Julius-eng/Vector-BMS/MCU.kicad_sch

## KiCad design MCU.kicad_sch (2026-03-11)

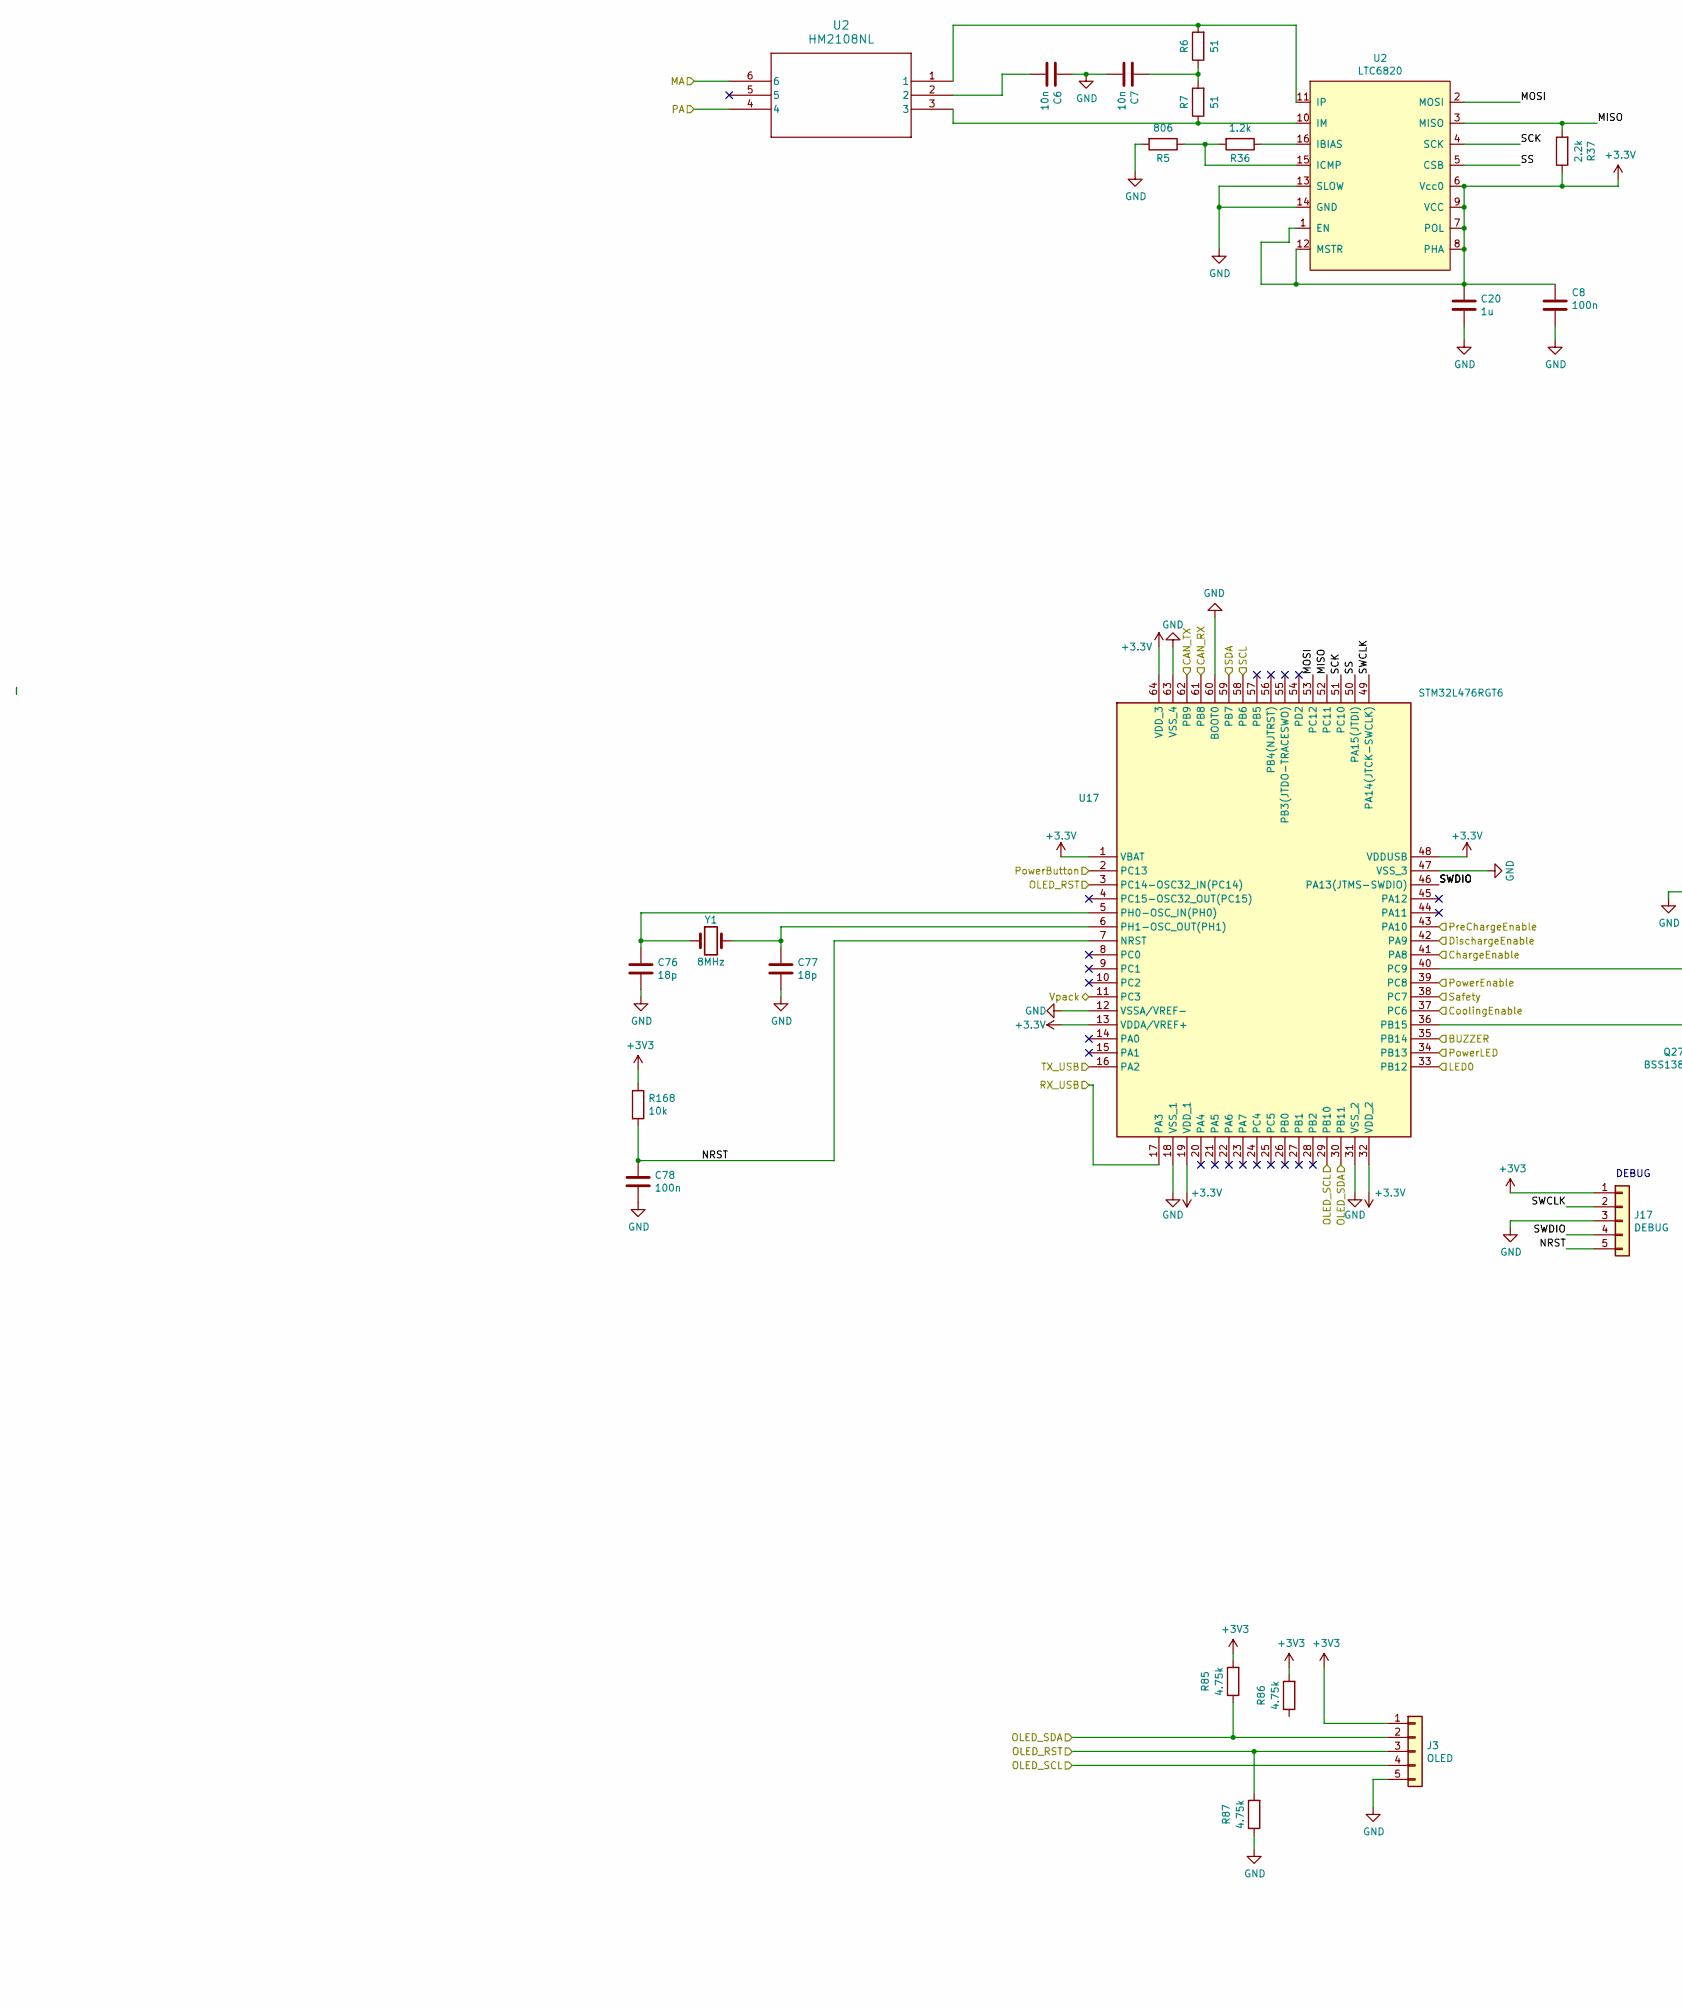
[picture p1: schematic MCU.kicad_sch, part in row 1, column 1]

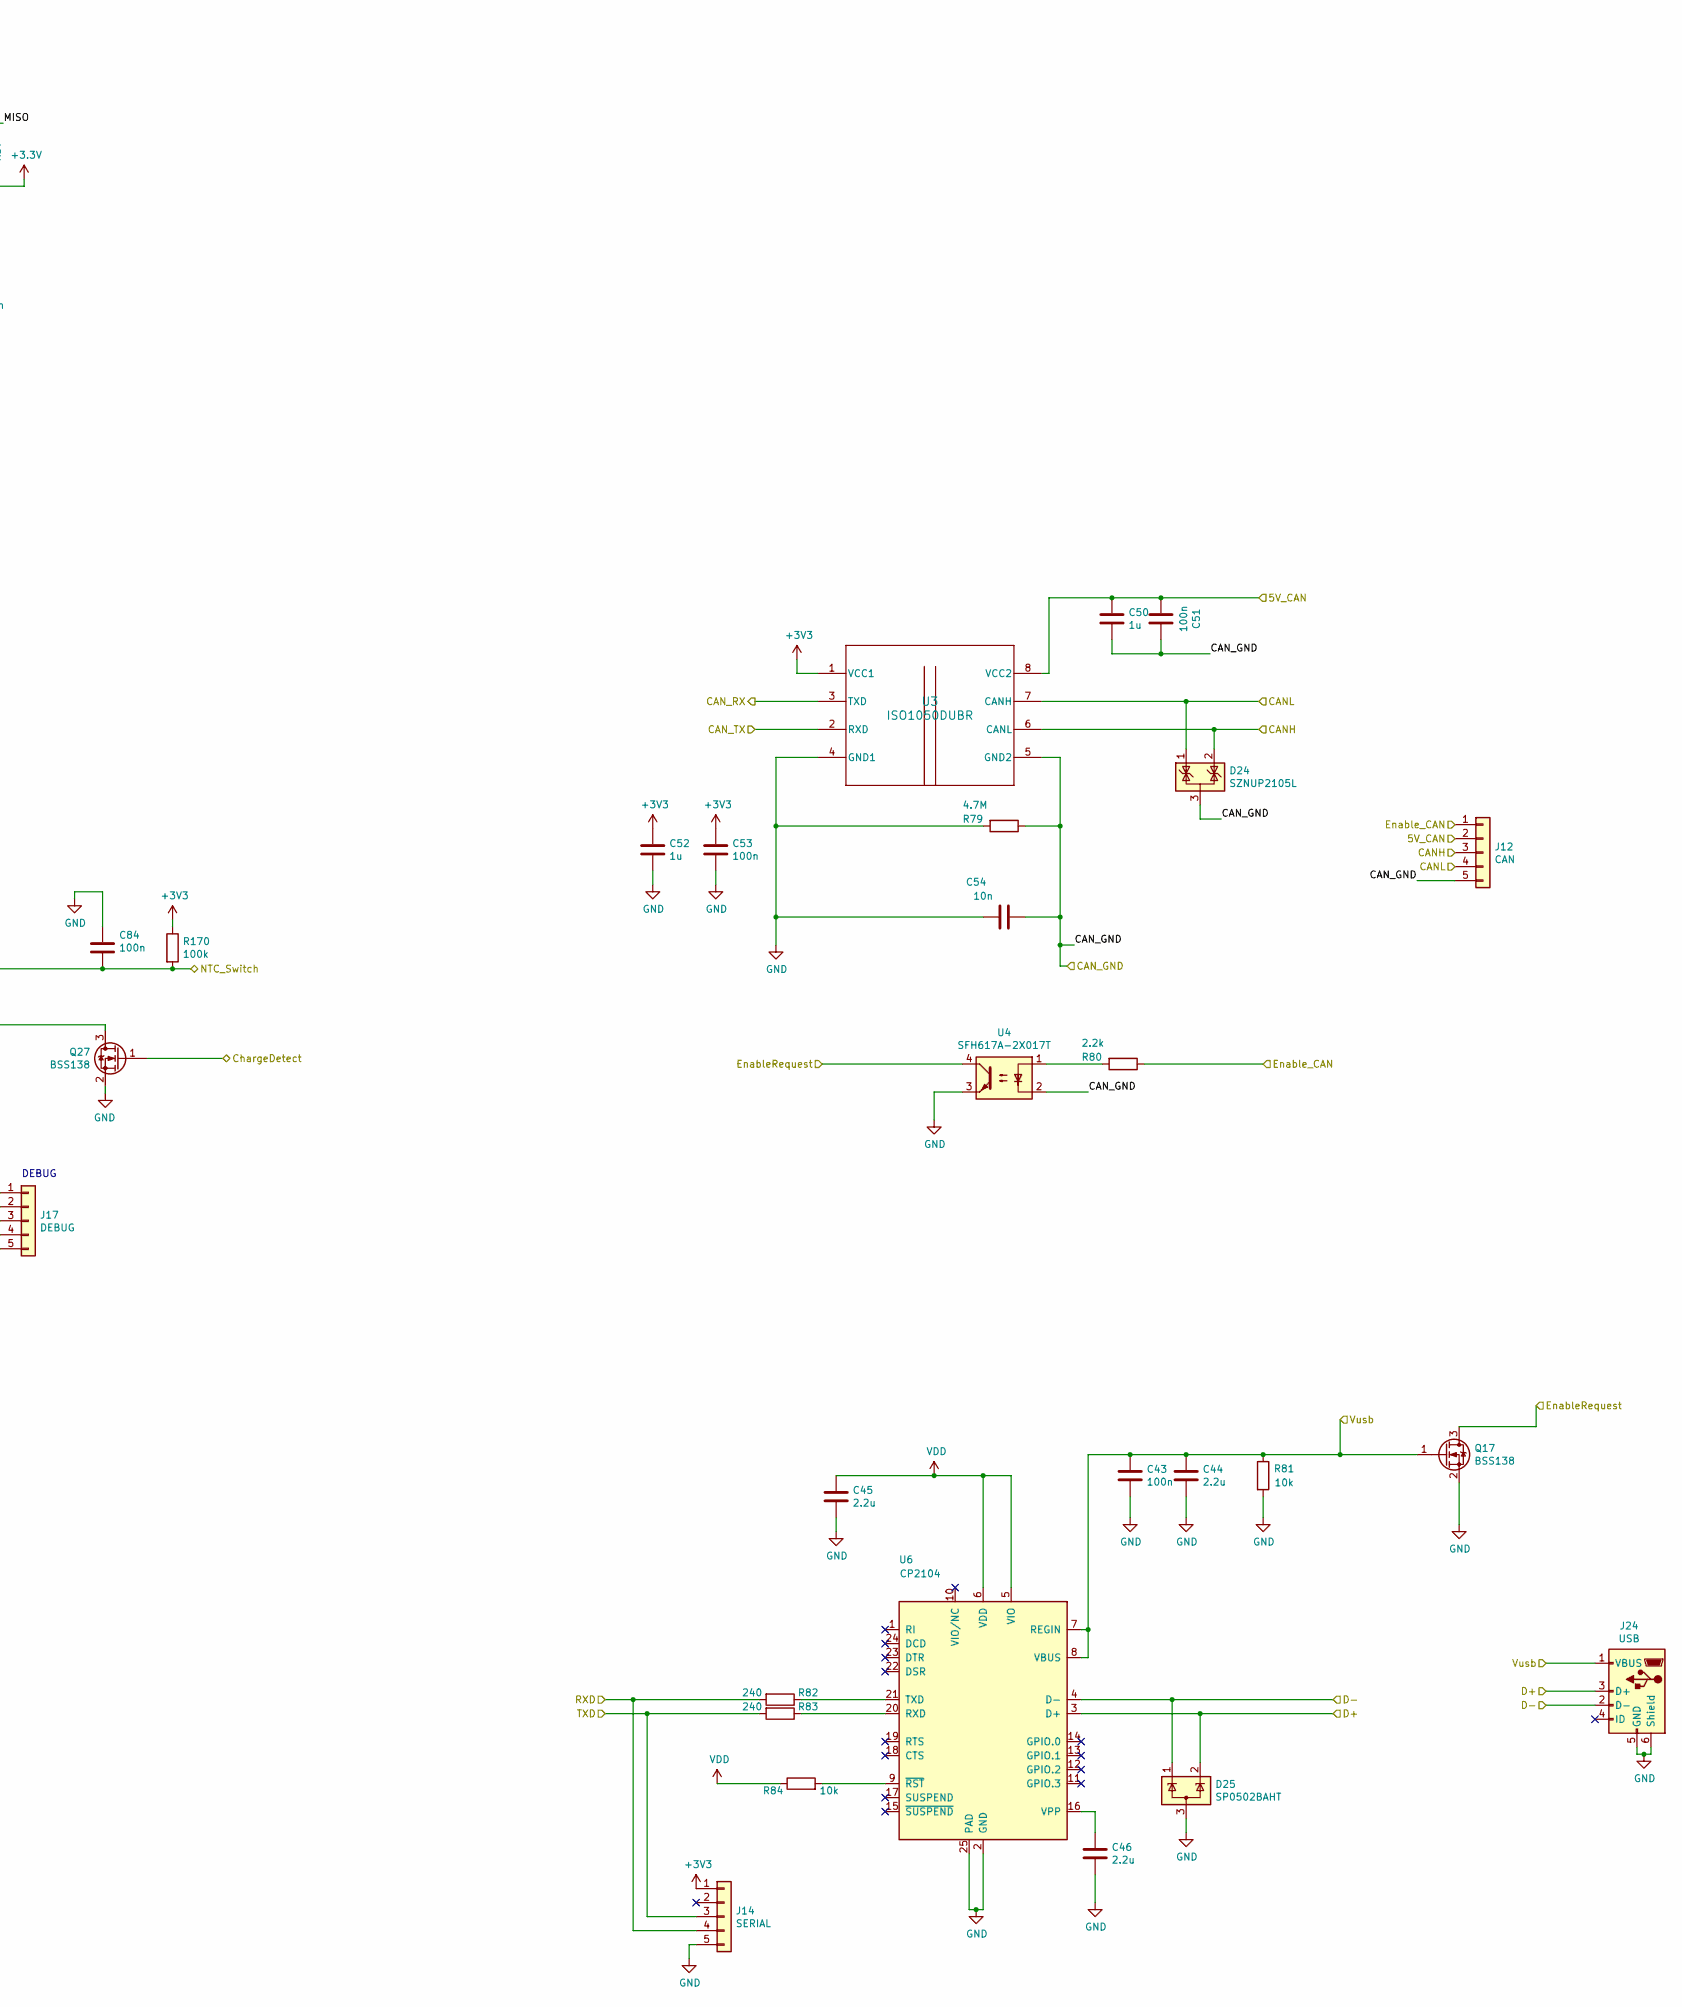
[picture p2: schematic MCU.kicad_sch, part in row 1, column 2]

Parts:
C6, C7: 10n; C_0603_1608Metric; MPN GRM188R71H103KA01D
C8, C43, C51, C53, C78, C84: 100n; C_0603_1608Metric; MPN GRM188R71E104KA01D
C20: 1u; C_0603_1608Metric; MPN GRM188R71E105KA12D
C44, C45, C46: 2.2u; C_0603_1608Metric; MPN GRM188R61A225KE34D
C50, C52: 1u; C_0805_2012Metric; MPN GRM188R71E105KA12D
C54: 10n; C_0805_2012Metric; Voltage 100V; MPN GRM188R71H103KA01D
C76, C77: 18p; C_0603_1608Metric; Voltage 50V; MPN GRM1885C1H180JA01D
D24: SZNUP2105L; SOT-23; MPN SZNUP2105LT1G
D25: SP0502BAHT; SOT-23; MPN SP0502BAHTG
J3: OLED; Molex_KK-6410-05_05x2.54mm_Straight; MPN 70543-0004
J12: CAN; Molex_KK-6410-05_05x2.54mm_Straight; MPN 70543-0004
J14: SERIAL; Molex_KK-6410-05_05x2.54mm_Straight; MPN 70543-0004
J17: DEBUG; Molex_PicoBlade_53398-0571_1x05-1MP_P1.25mm_Vertical; MPN 53398-0571
J24: USB; USB_Micro-B_Molex-105133-0001; MPN 47346-0001
Q17, Q27: BSS138; SOT-23; MPN BSS138
R5: 806; R_0603_1608Metric; MPN RC0603JR-071K2L
R6, R7: 51; R_0603_1608Metric; MPN RC0603JR-0751RL
R36: 1.2k; R_0603_1608Metric; MPN RC0603FR-07806RL
R37: 2.2k; R_0603_1608Metric; MPN RC0603JR-072K2L
R79: 4.7M; R_0805_2012Metric; Voltage 100V; MPN RC0805JR-0710ML
R80: 2.2k; R_0603_1608Metric; Voltage 100V; MPN RC0603JR-072K2L
R81, R84, R168: 10k; R_0603_1608Metric; MPN RMCF2512JT10K0
R82, R83: 240; R_0603_1608Metric; MPN RC0603FR-07240RL
R85, R86, R87: 4.75k; R_0603_1608Metric; MPN RC0603JR-074K7L
R170: 100k; R_0603_1608Metric; MPN RC0603JR-07100KL
U2: HM2108NL; SMT_2108NL_PUL; MPN HM2108NL
U3: ISO1050DUBR; DUB0008A_N; MPN ISO1050DUBR
U4: SFH617A-2X017T; SMDIP-4_W9.53mm_Clearance8mm; MPN SFH617A-2X009T
U6: CP2104; QFN-24-1EP_4x4mm_Pitch0.5mm; MPN CP2104-F03-GM
U17: STM32L476RGT6; QFP50P1200X1200X160-64N; MPN STM32L476RGT6; Mouser Part Number 511-STM32L476RGT6
Y1: 8MHz; Crystal_SMD_Abracon_ABM3-2pin_5.0x3.2mm; MPN ABM3-8.000MHZ-D2Y-T

Connections:
5V_CAN: C50.1, C51.2, J12.2, U3.8 (VCC2)
+3.3V: C8.1, C20.2, R37.1, U2.1 (EN), U2.6 (Vcc0), U2.7 (POL), U2.8 (PHA), U2.9 (VCC), U2.12 (MSTR), U17.1 (VBAT), U17.13 (VDDA/VREF+), U17.19 (VDD_1), U17.32 (VDD_2), U17.48 (VDDUSB), U17.64 (VDD_3)
+3V3: C52.1, C53.1, J3.1, J14.1, J17.1, R85.2, R86.2, R168.1, R170.1, U3.1 (VCC1)
BUZZER: U17.35 (PB14)
CANH: D24.2 (K), J12.3, U3.6 (CANL)
CANL: D24.1 (K), J12.4, U3.7 (CANH)
CAN_GND: C50.2, C51.1, C54.1, D24.3 (A), J12.5, R79.1, U3.5 (GND2), U4.2
CAN_RX: U3.3 (TXD), U17.61 (PB8)
CAN_TX: U3.2 (RXD), U17.62 (PB9)
ChargeDetect: Q27.1 (G)
ChargeEnable: U17.41 (PA8)
CoolingEnable: U17.37 (PC6)
D+: D25.2 (K), J24.3 (D+), U6.3 (D+)
D-: D25.1 (K), J24.2 (D-), U6.4 (D-)
DischargeEnable: U17.42 (PA9)
EnableRequest: Q17.3 (D), U4.4
Enable_CAN: J12.1, R80.1
GND: C6.2, C7.1, C8.2, C20.1, C43.2, C44.2, C45.2, C46.2, C52.2, C53.2, C54.2, C76.2, C77.2, C78.2, C84.1, D25.3 (A), J3.5, J14.5, J17.3, J24.5 (GND), J24.6 (Shield), Q17.2 (S), Q27.2 (S), R5.2, R79.2, R81.2, R87.1, U2.13 (SLOW), U2.14 (GND), U3.4 (GND1), U4.3, U6.2 (GND), U6.25 (PAD), U17.12 (VSSA/VREF-), U17.18 (VSS_1), U17.31 (VSS_2), U17.47 (VSS_3), U17.60 (BOOT0), U17.63 (VSS_4)
LED0: U17.33 (PB12)
MA: U2.6 (Vcc0)
MISO: R37.2, U2.3 (MISO), U17.52 (PC11)
MOSI: U2.2 (MOSI), U17.53 (PC12)
NRST: C78.1, J17.5, R168.2, U17.7 (NRST)
NTC_Switch: C84.2, R170.2, U17.40 (PC9)
unnamed: C6.1, U2.2 (MOSI)
unnamed: C7.2, R6.1, R7.2
unnamed: C46.1, U6.16 (VPP)
unnamed: C76.1, U17.5 (PH0-OSC_IN(PH0)), Y1.1
unnamed: C77.1, U17.6 (PH1-OSC_OUT(PH1)), Y1.2
unnamed: Q27.3 (D), U17.36 (PB15)
unnamed: R6.2, U2.1 (EN), U2.11 (IP)
unnamed: R7.1, U2.3 (MISO), U2.10 (IM)
unnamed: R36.1, U2.16 (IBIAS)
unnamed: R5.1, R36.2, U2.15 (ICMP)
unnamed: R80.2, U4.1
unnamed: R82.1, U6.21 (TXD)
unnamed: R83.1, U6.20 (RXD)
unnamed: R84.2, U6.9 (~RST)
OLED_RST: J3.3, R87.2, U17.3 (PC14-OSC32_IN(PC14))
OLED_SCL: J3.4, U17.29 (PB10)
OLED_SDA: J3.2, R85.1, U17.30 (PB11)
PA: U2.4 (SCK)
PowerButton: U17.2 (PC13)
PowerEnable: U17.39 (PC8)
PowerLED: U17.34 (PB13)
PreChargeEnable: U17.43 (PA10)
RXD: J14.4, R82.2
RX_USB: U17.17 (PA3)
SCK: U2.4 (SCK), U17.51 (PC10)
SCL: U17.58 (PB6)
SDA: U17.59 (PB7)
SS: U2.5 (CSB), U17.50 (PA15(JTDI))
SWCLK: J17.2, U17.49 (PA14(JTCK-SWCLK))
SWDIO: J17.4, U17.46 (PA13(JTMS-SWDIO))
Safety: U17.38 (PC7)
TXD: J14.3, R83.2
TX_USB: U17.16 (PA2)
VDD: C45.1, R84.1, U6.5 (VIO), U6.6 (VDD)
Vpack: U17.11 (PC3)
Vusb: C43.1, C44.1, J24.1 (VBUS), Q17.1 (G), R81.1, U6.7 (REGIN), U6.8 (VBUS)

Notes on the sheet:
DEBUG
