Julius-eng/Vector-BMS/Vector_BMS.kicad_sch

## KiCad design Vector_BMS.kicad_sch (2026-03-11, an earlier design)

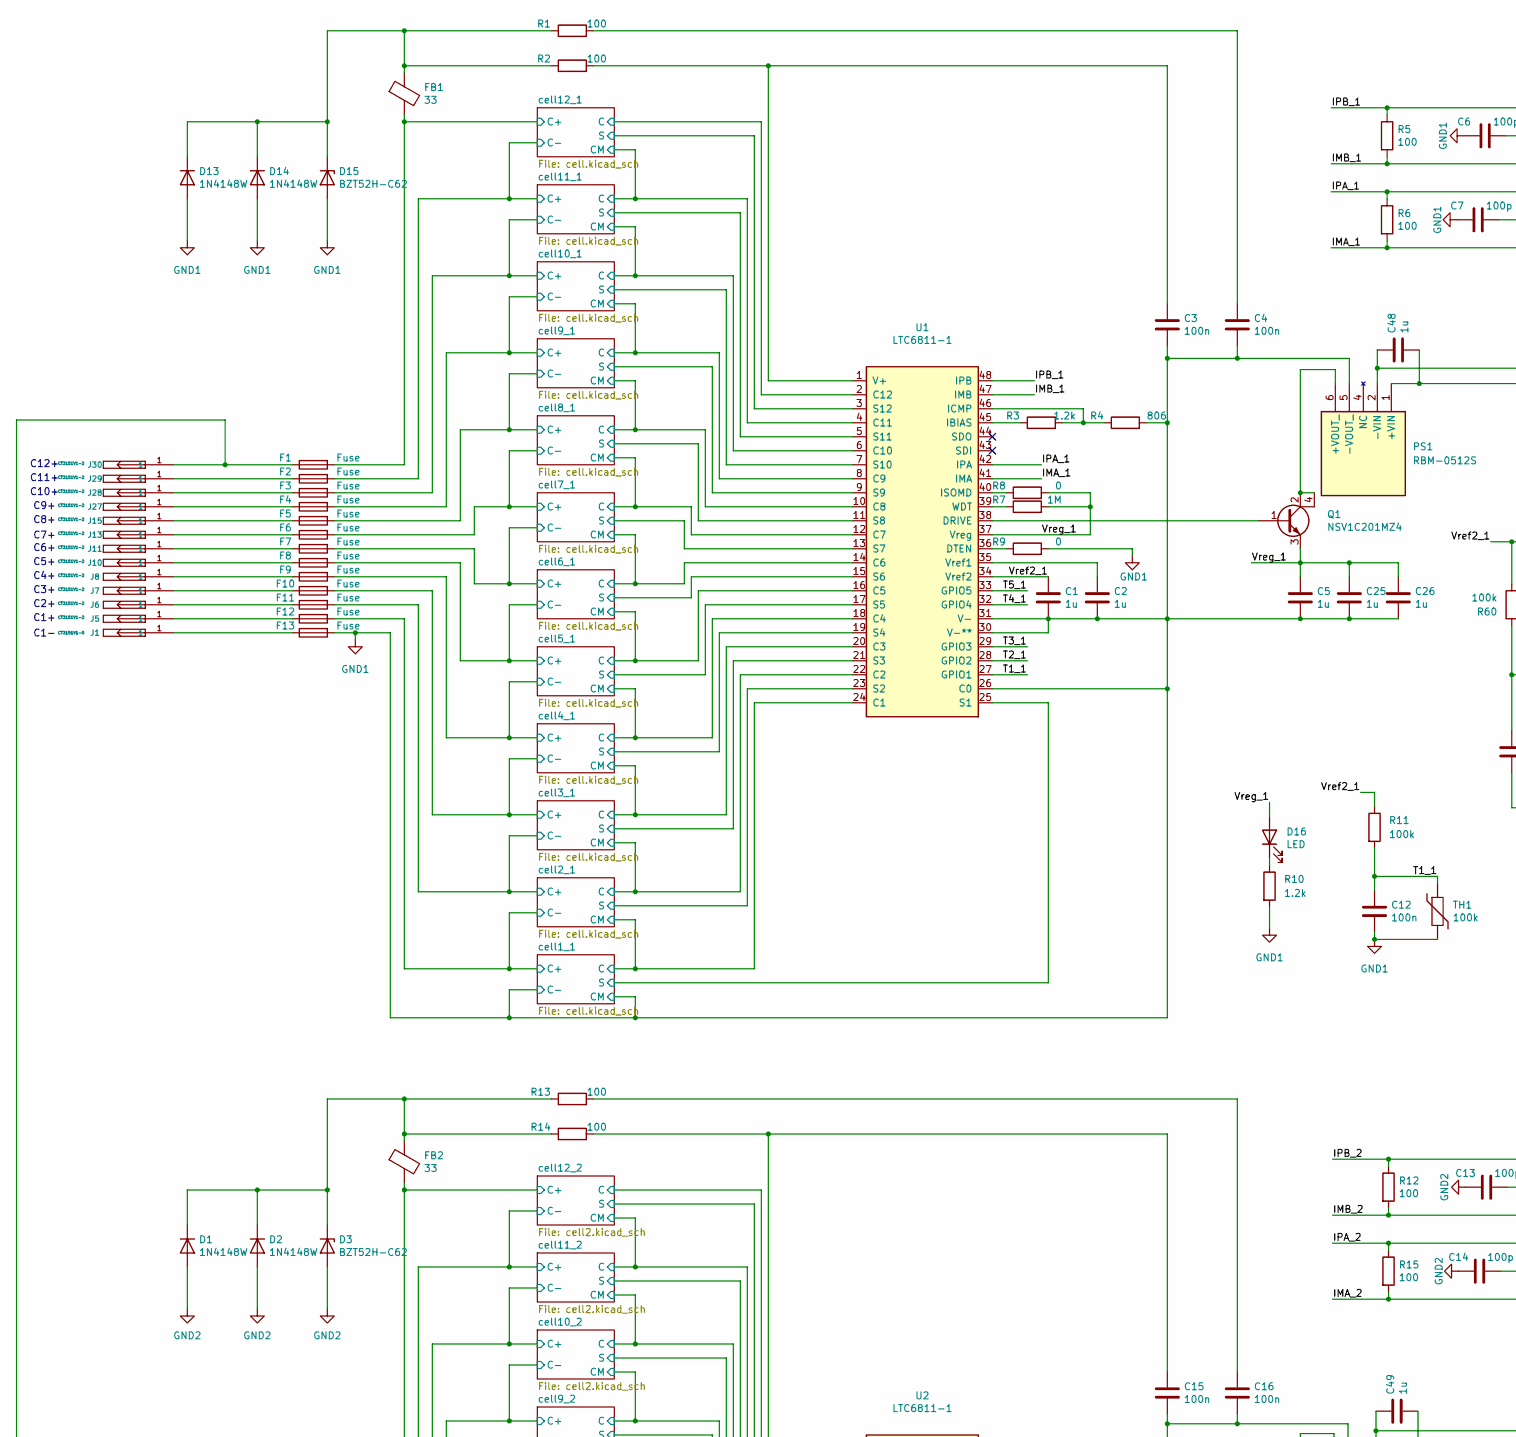
[picture p3: schematic Vector_BMS.kicad_sch, part in row 1, column 1]

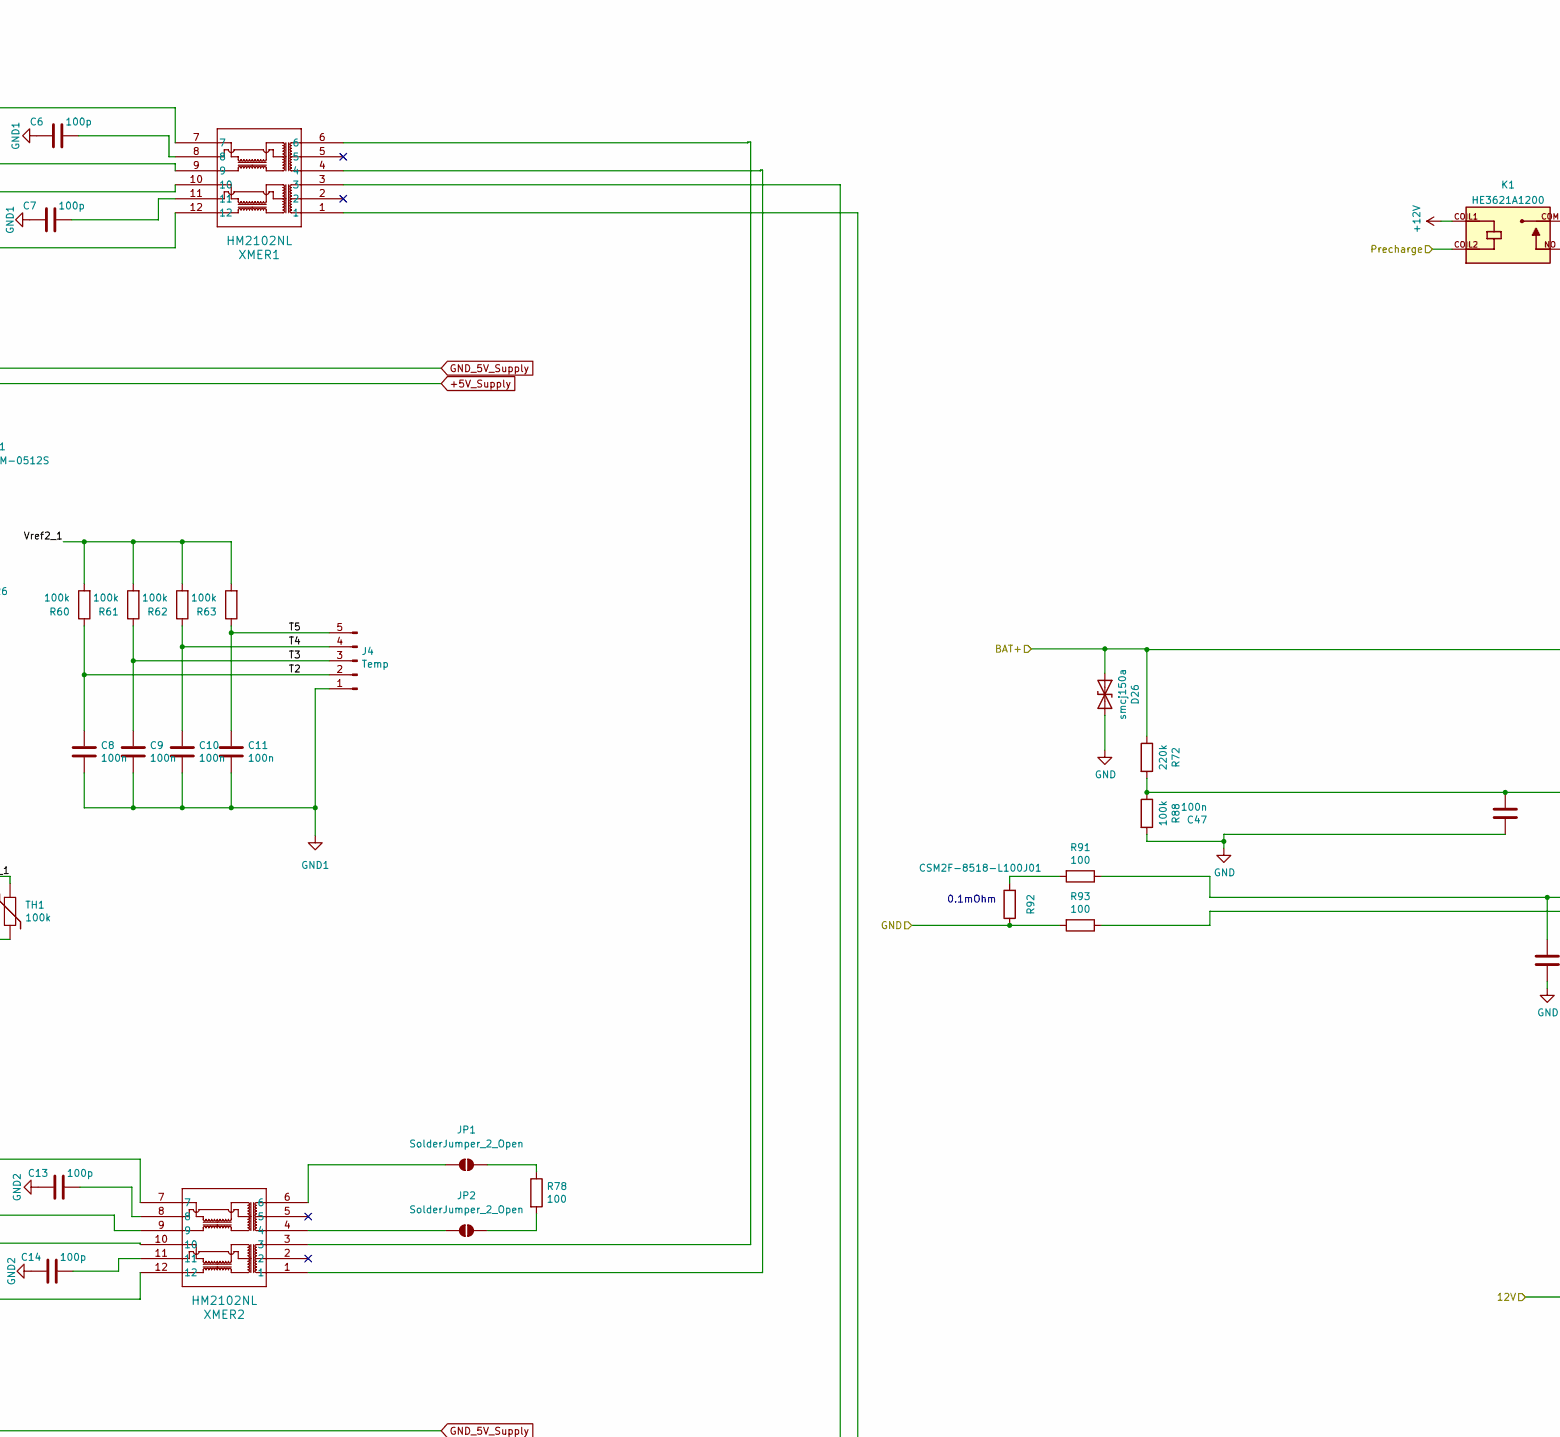
[picture p4: schematic Vector_BMS.kicad_sch, part in row 1, column 2]

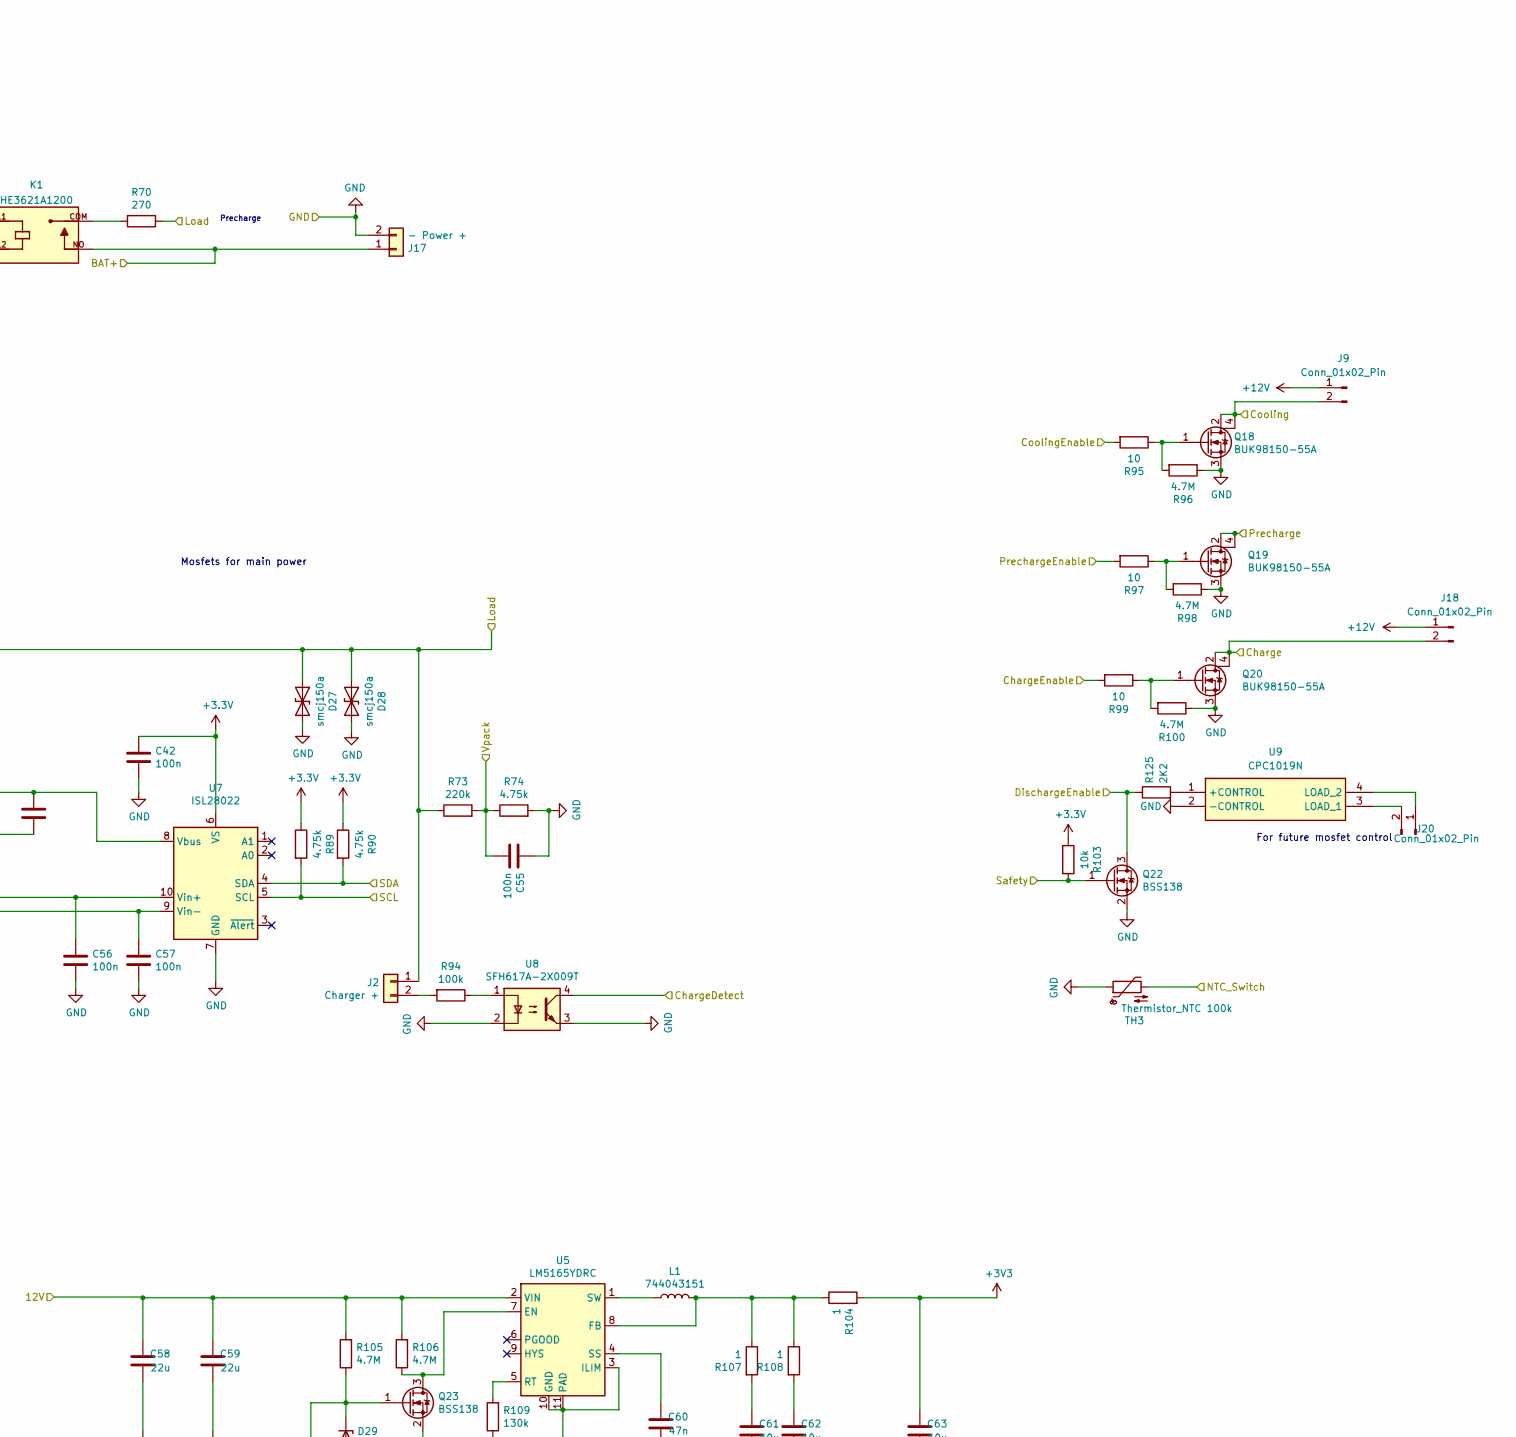
[picture p5: schematic Vector_BMS.kicad_sch, part in row 1, column 3]

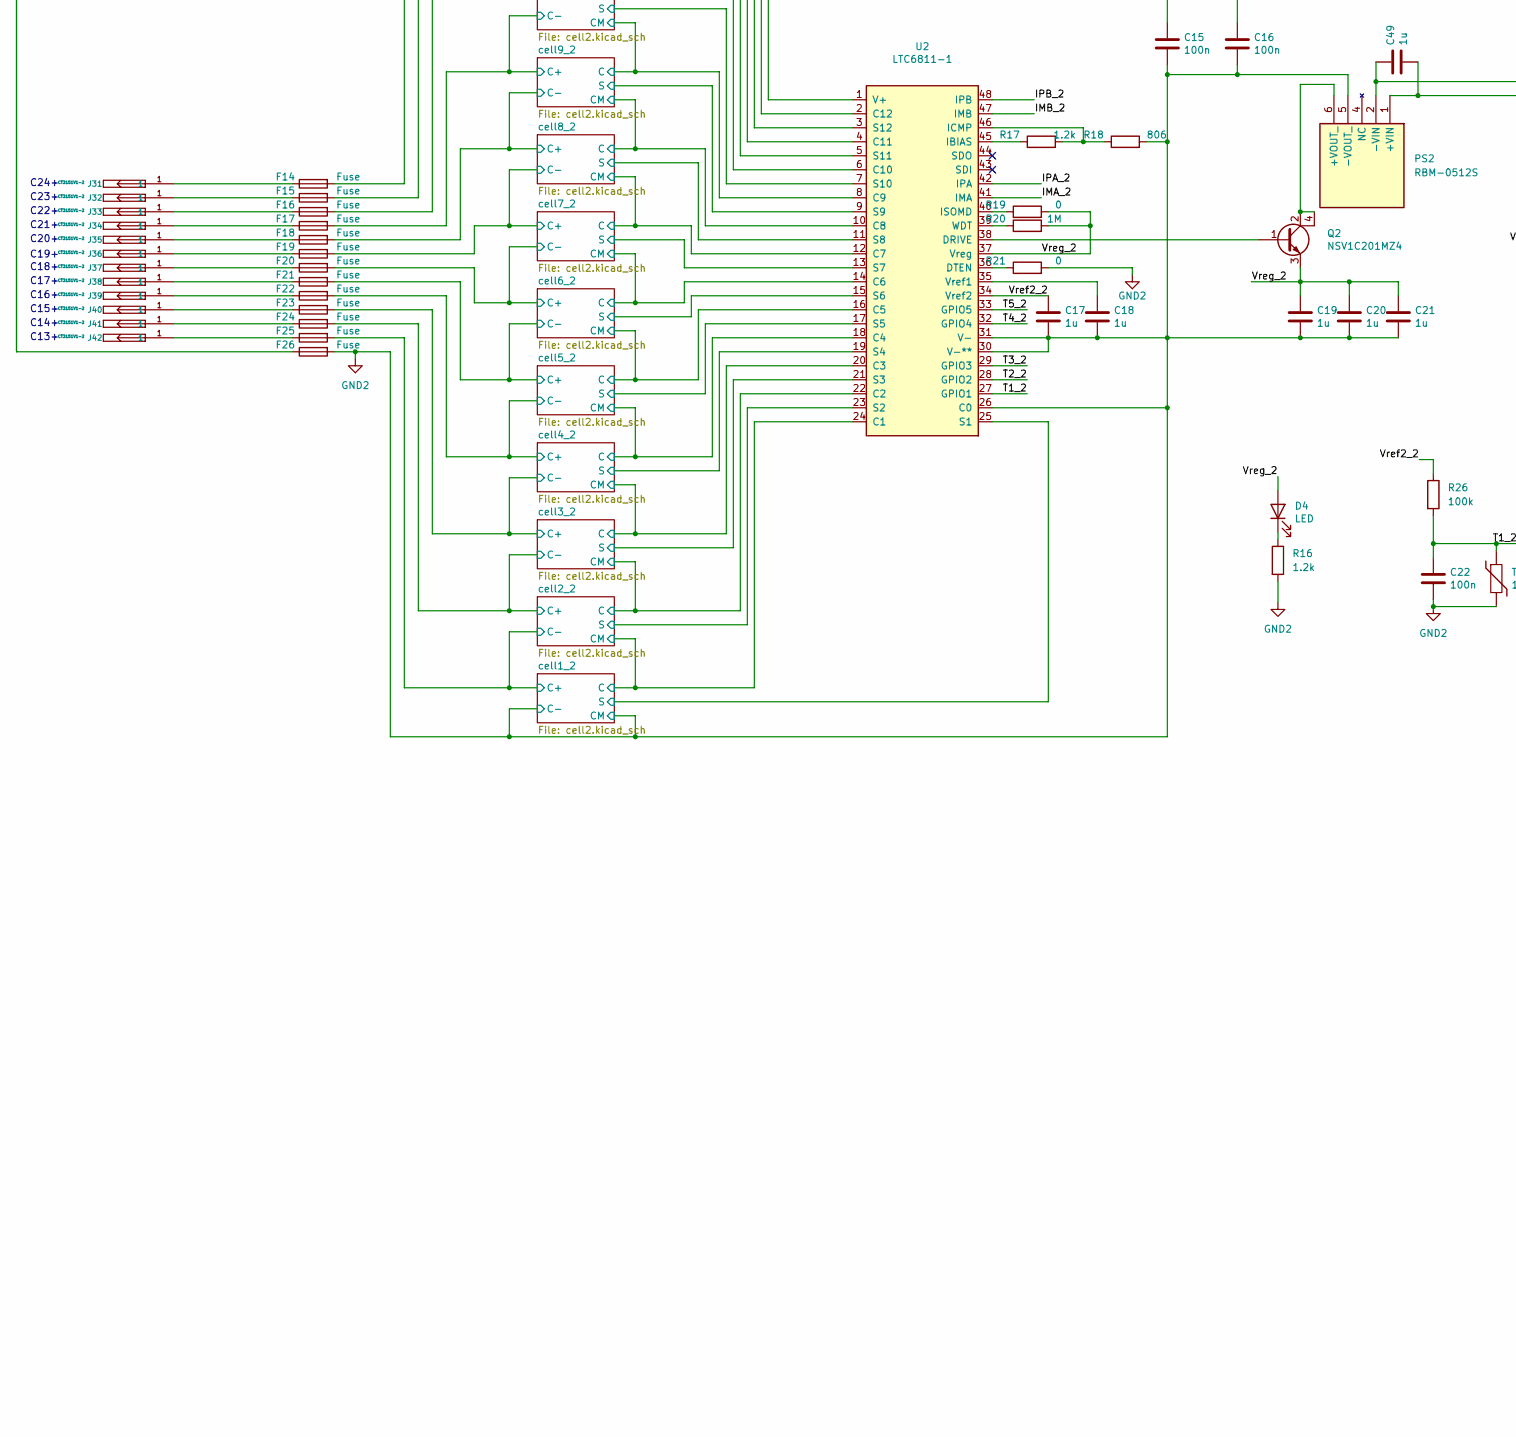
[picture p6: schematic Vector_BMS.kicad_sch, part in row 2, column 1]

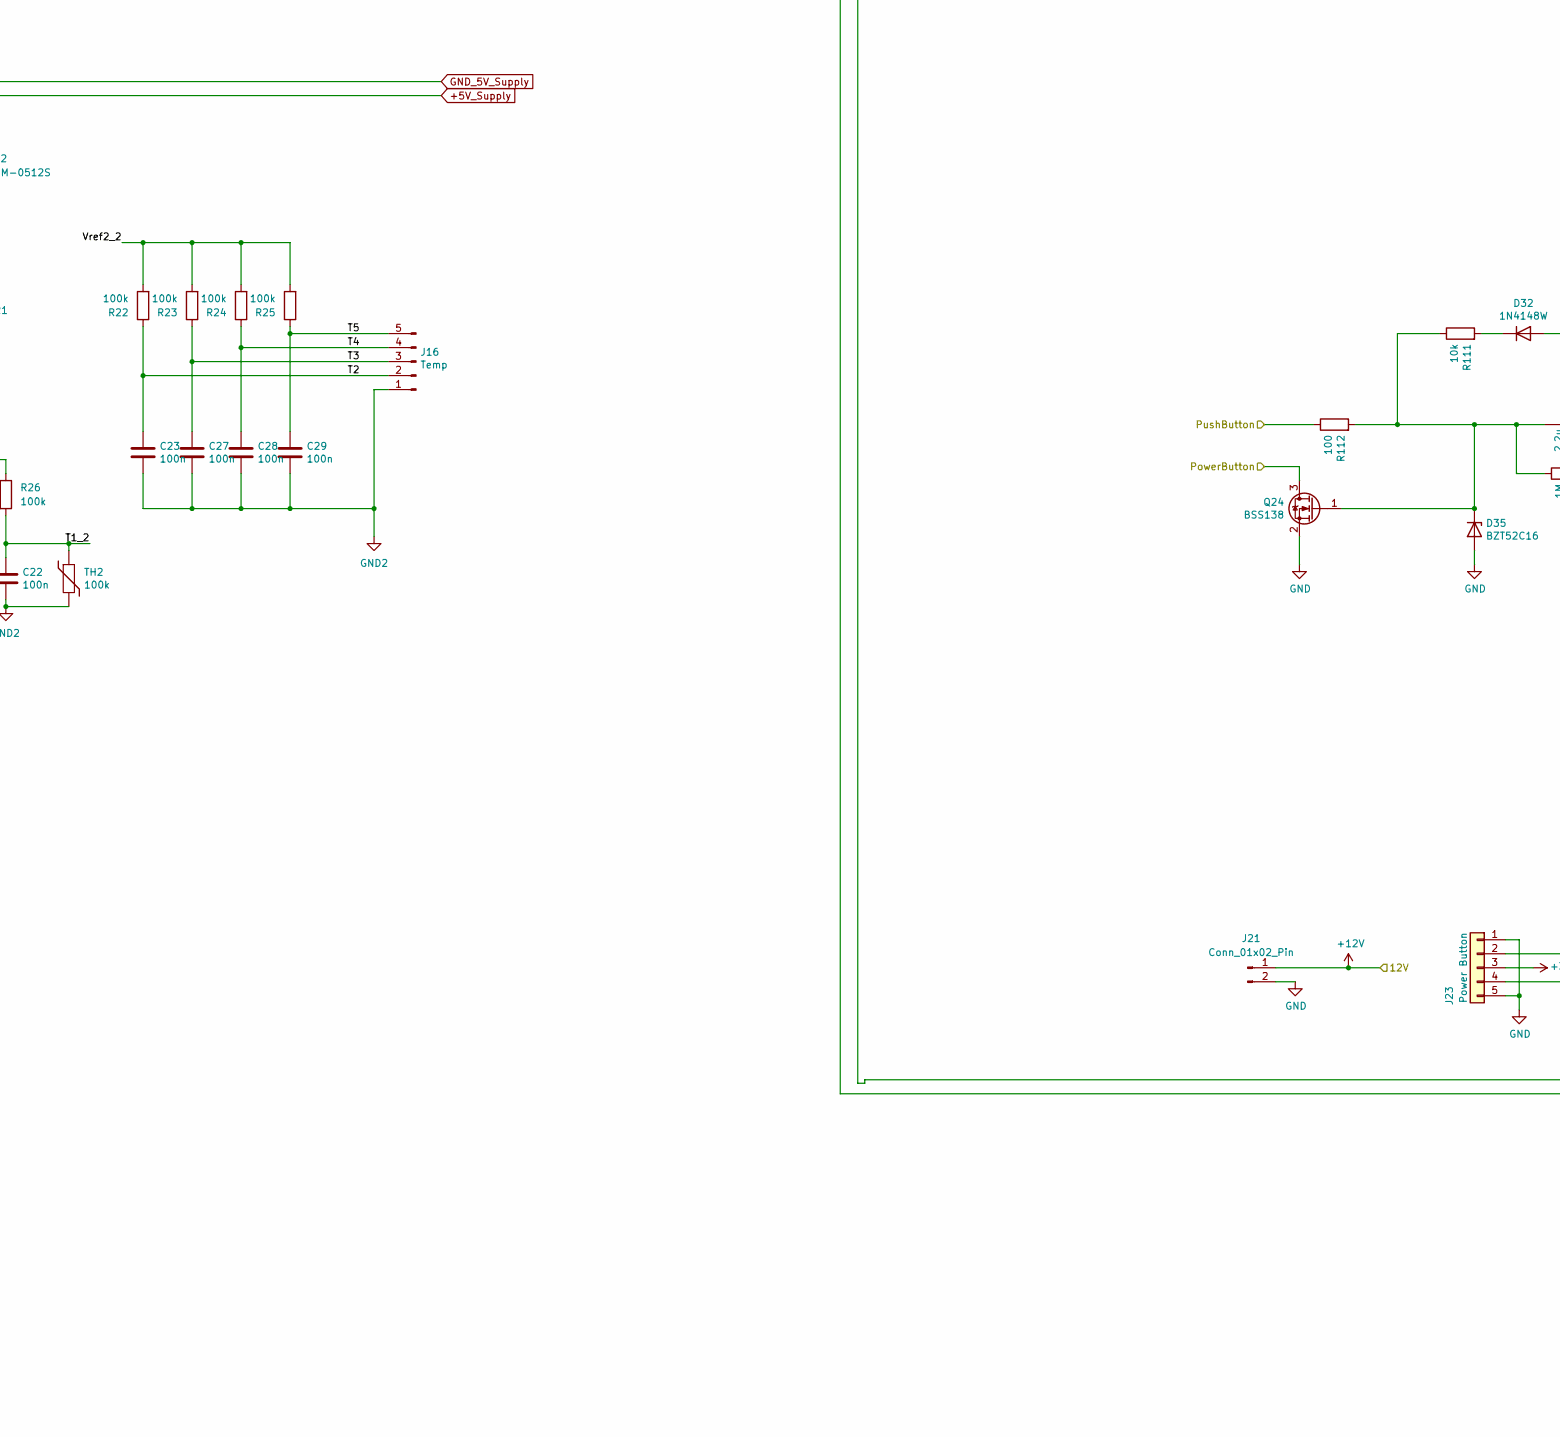
[picture p7: schematic Vector_BMS.kicad_sch, part in row 2, column 2]

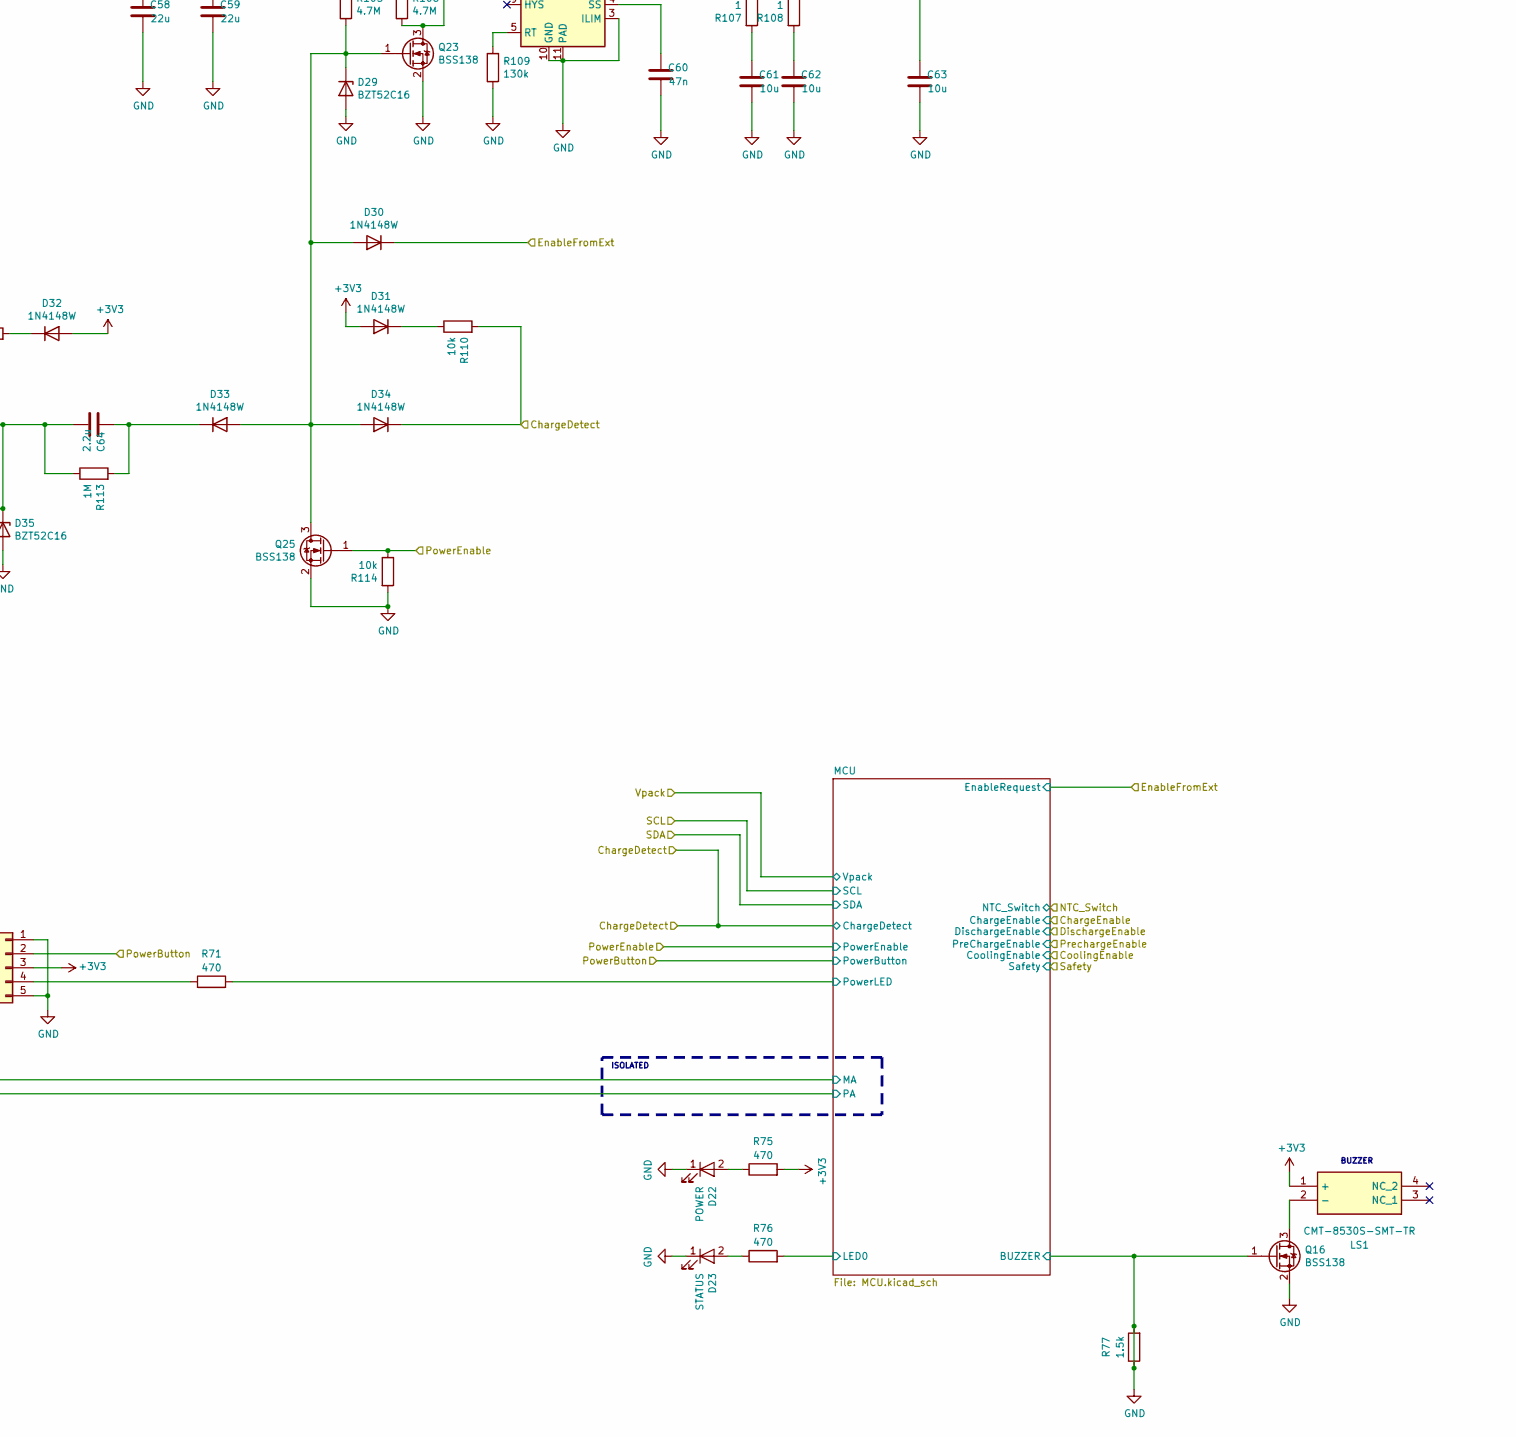
[picture p8: schematic Vector_BMS.kicad_sch, part in row 2, column 3]

Parts:
C1, C2, C5, C17, C18, C19, C20, C21, C25, C26, C48, C49: 1u; C_0805_2012Metric; MPN CL21B105KBFNNNE
C3, C4, C8, C9, C10, C11, C12, C15, C16, C22, C23, C27, C28, C29: 100n; C_0603_1608Metric; MPN CC0603KRX7R0BB104
C6, C7, C13, C14: 100p; C_0603_1608Metric; MPN CL10C101JB8NNNC
C42, C47, C55, C56, C57: 100n; C_0603_1608Metric; MPN GRM188R71E104KA01D
C58, C59: 22u; C_0805_2012Metric; Voltage 50V; MPN CL21A226MOQNNNE
C60: 47n; C_0603_1608Metric; Voltage 50V; MPN GCM188R71H473KA55D
C61, C62, C63: 10u; C_0603_1608Metric; Voltage 50V; MPN CL10A106MQ8NNNC
C64: 2.2u; C_0603_1608Metric; MPN GRM188R61A225KE34D
D1, D2, D13, D14, D30, D31, D32, D33, D34: 1N4148W; D_SOD-123; MPN 1N4148W-7-F
D3, D15: BZT52H-C62; D_SOD-123; MPN BZT52H-C62,115
D4, D16: LED; LED_0603_1608Metric; MPN SML-D12P8WT86C
D22: POWER; LED_0603_1608Metric; MPN SML-D12P8WT86C
D23: STATUS; LED_0603_1608Metric; MPN SML-D12P8WT86C
D26, D27, D28: smcj150a; D_SMC
D29, D35: BZT52C16; D_SOD-123; MPN BZT52C16-E3-08
F1, F2, F3, F4, F5, F6, F7, F8, F9, F10, F11, F12, F13, F14, F15, F16, F17, F18, F19, F20, F21, F22, F23, F24, F25, F26: Fuse
FB1, FB2: 33; R_0603_1608Metric; MPN BLM18PG330SN1D
J1: CT3151V1-0; CON4_CT3151V1-0_CTE
J2: Charger +; PhoenixContact_MCV_1,5_2-G-5.08_1x02_P5.08mm_Vertical; MPN 30.102
J4, J16: Temp; PinHeader_1x05_P2.54mm_Horizontal; MPN N/A
J5, J6, J7, J8, J10, J11, J13, J15, J27, J28, J29, J30, J31, J32, J33, J34, J35, J36, J37, J38, J39, J40, J41, J42: CT3151V1-2; CON4_CT3151V1-0_CTE
J9, J18, J20, J21: Conn_01x02_Pin
J17: - Power +; PhoenixContact_MCV_1,5_2-G-5.08_1x02_P5.08mm_Vertical; MPN 30.102
J23: Power Button; Molex_KK-6410-05_05x2.54mm_Straight; MPN 70543-0004
JP1, JP2: SolderJumper_2_Open
K1: HE3621A1200; KT12-1A-40L-THT_RELAY_KT12-1A-40L-THT; MPN HE3621A1200
L1: 744043151; L_Wuerth_WE-PD2-Typ-MS; MPN 744043151
LS1: CMT-8530S-SMT-TR; CMT8530SSMTTR; Mouser Part Number 490-CMT-8530S-SMT-TR
PS1, PS2: RBM-0512S; RBM0512S; Mouser Part Number 919-RBM-0512S
Q1, Q2: NSV1C201MZ4; SOT-223; MPN NSV1C201MZ4T1G
Q16, Q22, Q23, Q24, Q25: BSS138; SOT-23; MPN BSS138
Q18, Q19, Q20: BUK98150-55A; SOT-223; MPN BUK98150-55A/CUF
R1, R2, R5, R6, R12, R13, R14, R15, R78, R91, R93, R112: 100; R_0603_1608Metric; MPN RC0603FR-07100RL
R3, R10, R16, R17: 1.2k; R_0603_1608Metric; MPN RC0603JR-071K2L
R4, R18: 806; R_0603_1608Metric; MPN RC0603FR-07806RL
R7, R20, R113: 1M; R_0603_1608Metric; MPN RC0603JR-071ML
R8, R9, R19, R21: 0; R_0603_1608Metric; MPN RC0603JR-070RL
R11, R22, R23, R24, R25, R26, R60, R61, R62, R63, R88: 100k; R_0603_1608Metric; MPN RC0603JR-07100KL
R70: 270
R71, R75, R76: 470; R_0603_1608Metric; MPN RC0603JR-07470RL
R72, R73: 220k; R_2512_6332Metric; MPN 25121WF2203T4E
R74, R89, R90: 4.75k; R_0603_1608Metric; MPN RC0603JR-074K7L
R77: 1.5k; R_0603_1608Metric; MPN RC0603JR-071K5L
R92: CSM2F-8518-L100J01
R94: 100k; R_2512_6332Metric; MPN RC2512FK-07100KL
R95, R97, R99: 10; R_0603_1608Metric; MPN RC0603JR-0710RL
R96, R98, R100, R105, R106: 4.7M; R_0603_1608Metric; MPN RC0603FR-074M7L
R103, R110, R111, R114: 10k; R_0603_1608Metric; MPN RMCF2512JT10K0
R104, R107, R108: 1; R_0603_1608Metric; MPN RC0603FR-071RL
R109: 130k; R_0603_1608Metric; MPN RC0603FR-07130KL
R125: 2K2; R_0805_2012Metric_Pad1.20x1.40mm_HandSolder
TH1, TH2: 100k; R_0805_2012Metric; MPN SDNT2012X104F4250FTF
TH3: Thermistor_NTC 100k; R_0805_2012Metric; MPN SDNT2012X104F4250FTF
U1, U2: LTC6811-1; TSSOP-48_6.1x12.5mm_Pitch0.5mm; MPN LTC6811HG-1#PBF
U5: LM5165YDRC; Texas_S-PVSON-N10_ThermalVias; MPN LM5165YDRCT
U7: ISL28022; VSSOP-10_3x3mm_P0.5mm; MPN ISL28022FUZ-T7A
U8: SFH617A-2X009T; SMDIP-4_W9.53mm_Clearance8mm; MPN SFH617A-2X009T
U9: CPC1019N; SOP254P610X218-4N; Mouser Part Number 849-CPC1019N
XMER1, XMER2: HM2102NL; HM2102NL_PUL; MPN HM2102NLT

Connections:
+3.3V: C42.2, R89.1, R90.1, R103.1, U7.6 (VS)
+3V3: C63.2, D31.2 (A), D32.2 (A), J23.3, LS1.1 (+), R75.2, R104.2
+5V_Supply: C48.2, C49.2, PS1.1 (+VIN), PS2.1 (+VIN)
+12V: C58.2, C59.2, J9.1, J18.1, J21.1, K1.COIL1, R105.2, R106.2, U5.2 (VIN)
BAT+: D26.1 (A1), D27.1 (A1), D28.1 (A1), J2.1, J17.1, K1.NO, R70.1, R72.1, R73.1
C: U1.2 (C12), U1.6 (C10), U1.12 (C7), U1.14 (C6), U1.16 (C5), U1.20 (C3), U1.22 (C2), U2.2 (C12), U2.8 (C9), U2.12 (C7), U2.16 (C5)
C+: F1.2, F3.2, F6.2, F7.2, F8.2, F10.2, F11.2, F14.2, F17.2, F19.2, F21.2, FB1.2, FB2.2
C-: F2.2, F4.2, F5.2, F9.2, F12.2, F15.2, F16.2, F18.2, F20.2, F22.2, F23.2, F24.2, F25.2
CM: U1.4 (C11), U1.8 (C9), U1.10 (C8), U1.18 (C4), U1.24 (C1), U2.4 (C11), U2.6 (C10), U2.10 (C8), U2.14 (C6), U2.18 (C4), U2.20 (C3), U2.22 (C2), U2.24 (C1)
Charge: J18.2, Q20.2 (D), Q20.4 (D)
ChargeDetect: D34.1 (K), R110.2, U8.4
ChargeEnable: R99.2
Cooling: J9.2, Q18.2 (D), Q18.4 (D)
CoolingEnable: R95.2
DischargeEnable: Q22.3 (D), R125.1
EnableFromExt: D30.1 (K)
GND: C42.1, C47.2, C55.2, C56.1, C57.1, C58.1, C59.1, C60.1, C61.1, C62.1, C63.1, D22.1 (K), D23.1 (K), D26.2 (A2), D27.2 (A2), D28.2 (A2), D29.2 (A), D35.2 (A), J17.2, J21.2, J23.1, J23.5, Q16.1 (G), Q16.2 (S), Q18.3 (S), Q19.3 (S), Q20.3 (S), Q22.2 (S), Q23.2 (S), Q24.2 (S), Q25.2 (S), R74.2, R77.1, R77.2, R88.2, R92.1, R93.2, R96.1, R98.1, R100.1, R109.1, R114.2, TH3.1, U5.3 (ILIM), U5.10 (GND), U5.11 (PAD), U7.7 (GND), U8.2, U8.3, U9.2 (-CONTROL)
GND1: C1.2, C2.2, C3.2, C4.2, C5.2, C6.2, C7.2, C8.2, C9.2, C10.2, C11.2, C12.2, C25.2, C26.2, D13.2 (A), D14.2 (A), D15.2 (A), F13.2, J4.1, PS1.5 (-VOUT_), R4.2, R9.2, R10.2, TH1.2, U1.26 (C0), U1.30 (V-**), U1.31 (V-)
GND2: C13.2, C14.2, C15.2, C16.2, C17.2, C18.2, C19.2, C20.2, C21.2, C22.2, C23.2, C27.2, C28.2, C29.2, D1.2 (A), D2.2 (A), D3.2 (A), F26.2, J16.1, PS2.5 (-VOUT_), R16.2, R18.2, R21.2, TH2.2, U2.26 (C0), U2.30 (V-**), U2.31 (V-)
GND_5V_Supply: C48.1, C49.1, PS1.2 (-VIN), PS2.2 (-VIN)
IMA_1: R6.2, U1.41 (IMA), XMER1.12
IMA_2: R15.2, U2.41 (IMA), XMER2.12
IMB_1: R5.2, U1.47 (IMB), XMER1.9
IMB_2: R12.2, U2.47 (IMB), XMER2.9
IPA_1: R6.1, U1.42 (IPA), XMER1.10
IPA_2: R15.1, U2.42 (IPA), XMER2.10
IPB_1: R5.1, U1.48 (IPB), XMER1.7
IPB_2: R12.1, U2.48 (IPB), XMER2.7
LED0: R76.2
MA: XMER1.1
NTC_Switch: TH3.2
unnamed: C2.1, U1.35 (Vref1)
unnamed: C3.1, R2.2, U1.1 (V+)
unnamed: C4.1, R1.2
unnamed: C6.1, XMER1.8
unnamed: C7.1, XMER1.11
unnamed: C13.1, XMER2.8
unnamed: C14.1, XMER2.11
unnamed: C15.1, R14.2, U2.1 (V+)
unnamed: C16.1, R13.2
unnamed: C18.1, U2.35 (Vref1)
unnamed: C47.1, R72.2, R88.1, U7.8 (Vbus)
unnamed: C56.2, R91.1, U7.10 (Vin+)
unnamed: C57.2, R93.1, U7.9 (Vin-)
unnamed: C60.2, U5.4 (SS)
unnamed: C61.2, R107.2
unnamed: C62.2, R108.2
unnamed: C64.1, D35.1 (K), Q24.1 (G), R111.1, R112.2, R113.1
unnamed: C64.2, D33.1 (K), R113.2
unnamed: D1.1 (K), D2.1 (K), D3.1 (K), FB2.1, R13.1, R14.1
unnamed: D4.1 (K), R16.1
unnamed: D13.1 (K), D14.1 (K), D15.1 (K), FB1.1, R1.1, R2.1
unnamed: D16.1 (K), R10.1
unnamed: D22.2 (A), R75.1
unnamed: D23.2 (A), R76.1
unnamed: D29.1 (K), D30.2 (A), D33.2 (A), D34.2 (A), Q23.1 (G), Q25.3 (D), R105.1
unnamed: D31.1 (K), R110.1
unnamed: D32.1 (K), R111.2
unnamed: F1.1, F26.1, J30.1
unnamed: F2.1, J29.1
unnamed: F3.1, J28.1
unnamed: F4.1, J27.1
unnamed: F5.1, J15.1
unnamed: F6.1, J13.1
unnamed: F7.1, J11.1
unnamed: F8.1, J10.1
unnamed: F9.1, J8.1
unnamed: F10.1, J7.1
unnamed: F11.1, J6.1
unnamed: F12.1, J5.1
unnamed: F13.1, J1.1
unnamed: F14.1, J31.1
unnamed: F15.1, J32.1
unnamed: F16.1, J33.1
unnamed: F17.1, J34.1
unnamed: F18.1, J35.1
unnamed: F19.1, J36.1
unnamed: F20.1, J37.1
unnamed: F21.1, J38.1
unnamed: F22.1, J39.1
unnamed: F23.1, J40.1
unnamed: F24.1, J41.1
unnamed: F25.1, J42.1
unnamed: J2.2, R94.2
unnamed: J20.1, U9.4 (LOAD_2)
unnamed: J20.2, U9.3 (LOAD_1)
unnamed: J23.4, R71.1
unnamed: JP1.1 (A), XMER2.6
unnamed: JP1.2 (B), R78.1
unnamed: JP2.1 (A), XMER2.4
unnamed: JP2.2 (B), R78.2
unnamed: K1.COM, R70.2
unnamed: L1.1, U5.1 (SW)
unnamed: L1.2, R104.1, R107.1, R108.1, U5.8 (FB)
unnamed: LS1.2 (-), Q16.3 (D)
unnamed: PS1.6 (+VOUT_), Q1.2 (C), Q1.4 (C)
unnamed: PS2.6 (+VOUT_), Q2.2 (C), Q2.4 (C)
unnamed: Q1.1 (B), U1.38 (DRIVE)
unnamed: Q2.1 (B), U2.38 (DRIVE)
unnamed: Q18.1 (G), R95.1, R96.2
unnamed: Q19.1 (G), R97.1, R98.2
unnamed: Q20.1 (G), R99.1, R100.2
unnamed: Q23.3 (D), R106.1, U5.7 (EN)
unnamed: R3.1, U1.45 (IBIAS)
unnamed: R3.2, R4.1, U1.46 (ICMP)
unnamed: R7.1, U1.39 (WDT)
unnamed: R8.1, U1.40 (ISOMD)
unnamed: R9.1, U1.36 (DTEN)
unnamed: R17.1, U2.45 (IBIAS)
unnamed: R17.2, R18.1, U2.46 (ICMP)
unnamed: R19.1, U2.40 (ISOMD)
unnamed: R20.1, U2.39 (WDT)
unnamed: R21.1, U2.36 (DTEN)
unnamed: R91.2, R92.2
unnamed: R94.1, U8.1
unnamed: R109.2, U5.5 (RT)
unnamed: R125.2, U9.1 (+CONTROL)
unnamed: XMER1.4, XMER2.1
unnamed: XMER1.6, XMER2.3
PA: XMER1.3
PowerButton: J23.2, Q24.3 (D)
PowerEnable: Q25.1 (G), R114.1
PowerLED: R71.2
Precharge: K1.COIL2, Q19.2 (D), Q19.4 (D)
PrechargeEnable: R97.2
PushButton: R112.1
S: U1.3 (S12), U1.5 (S11), U1.7 (S10), U1.9 (S9), U1.11 (S8), U1.13 (S7), U1.15 (S6), U1.17 (S5), U1.19 (S4), U1.21 (S3), U1.23 (S2), U1.25 (S1), U2.3 (S12), U2.5 (S11), U2.7 (S10), U2.9 (S9), U2.11 (S8), U2.13 (S7), U2.15 (S6), U2.17 (S5), U2.19 (S4), U2.21 (S3), U2.23 (S2), U2.25 (S1)
SCL: R89.2, U7.5 (SCL)
SDA: R90.2, U7.4 (SDA)
Safety: Q22.1 (G), R103.2
T1_1: C12.1, R11.2, TH1.1, U1.27 (NC)
T1_2: C22.1, R26.2, TH2.1, U2.27 (NC)
T2: C8.1, C23.1, J4.2, J16.2, R22.1, R60.1
T2_1: U1.28 (GPIO2)
T2_2: U2.28 (GPIO2)
T3: C9.1, C27.1, J4.3, J16.3, R23.1, R61.1
T3_1: U1.29 (GPIO3)
T3_2: U2.29 (GPIO3)
T4: C10.1, C28.1, J4.4, J16.4, R24.1, R62.1
T4_1: U1.32 (GPIO4)
T4_2: U2.32 (GPIO4)
T5: C11.1, C29.1, J4.5, J16.5, R25.1, R63.1
T5_1: U1.33 (NC)
T5_2: U2.33 (NC)
Vpack: C55.1, R73.2, R74.1
Vref2_1: C1.1, R11.1, R60.2, R61.2, R62.2, R63.2, U1.34 (Vref2)
Vref2_2: C17.1, R22.2, R23.2, R24.2, R25.2, R26.1, U2.34 (Vref2)
Vreg_1: C5.1, C25.1, C26.1, D16.2 (A), Q1.3 (E), R7.2, R8.2, U1.37 (Vreg)
Vreg_2: C19.1, C20.1, C21.1, D4.2 (A), Q2.3 (E), R19.2, R20.2, U2.37 (Vreg)

Notes on the sheet:
C2+
C17+
Mosfets for main power
C1+
C11+
C4+
C20+
For future mosfet control
BUZZER
C23+
C3+
0.1mOhm
C22+
C18+
Precharge
C13+
C21+
C5+
C8+
C1-
C19+
C12+
C9+
C10+
C6+
C15+
ISOLATED
C24+
C7+
C14+
C16+
