Julius-eng/Vector-BMS/cell2.kicad_sch

## KiCad design cell2.kicad_sch (2026-03-11, an earlier design)

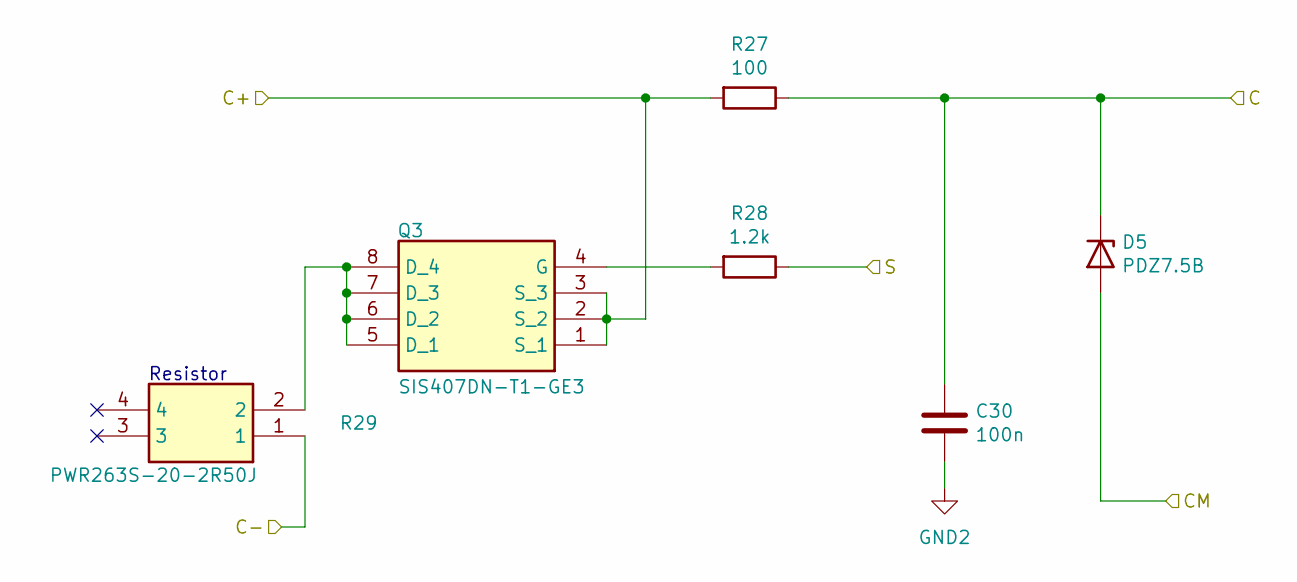
[picture p9: schematic cell2.kicad_sch]

Parts:
C30: 100n; C_0603_1608Metric; MPN CC0603KRX7R0BB104
D5: PDZ7.5B; D_SOD-323; MPN PDZ7.5BZ
Q3: SIS407DN-T1-GE3; SIS862DNT1GE3; MPN TSM2323CX RFG; Mouser Part Number 781-SIS407DN-T1-GE3
R27: 100; R_0603_1608Metric; MPN RC0603FR-07100RL
R28: 1.2k; R_0603_1608Metric; MPN RC0603JR-073K3L
R29: PWR263S-20-2R50J; PWR263S2010R0F; MPN RTT25360JTE

Connections:
C: C30.1, D5.1 (K), R27.1
C+: Q3.1 (S_1), Q3.2 (S_2), Q3.3 (S_3), R27.2
C-: R29.1
CM: D5.2 (A)
GND2: C30.2
unnamed: Q3.4 (G), R28.2
unnamed: Q3.5 (D_1), Q3.6 (D_2), Q3.7 (D_3), Q3.8 (D_4), R29.2
S: R28.1

Notes on the sheet:
Resistor
