Julius-eng/Vector-BMS/cell.kicad_sch

## KiCad design cell.kicad_sch (2026-03-11, an earlier design)

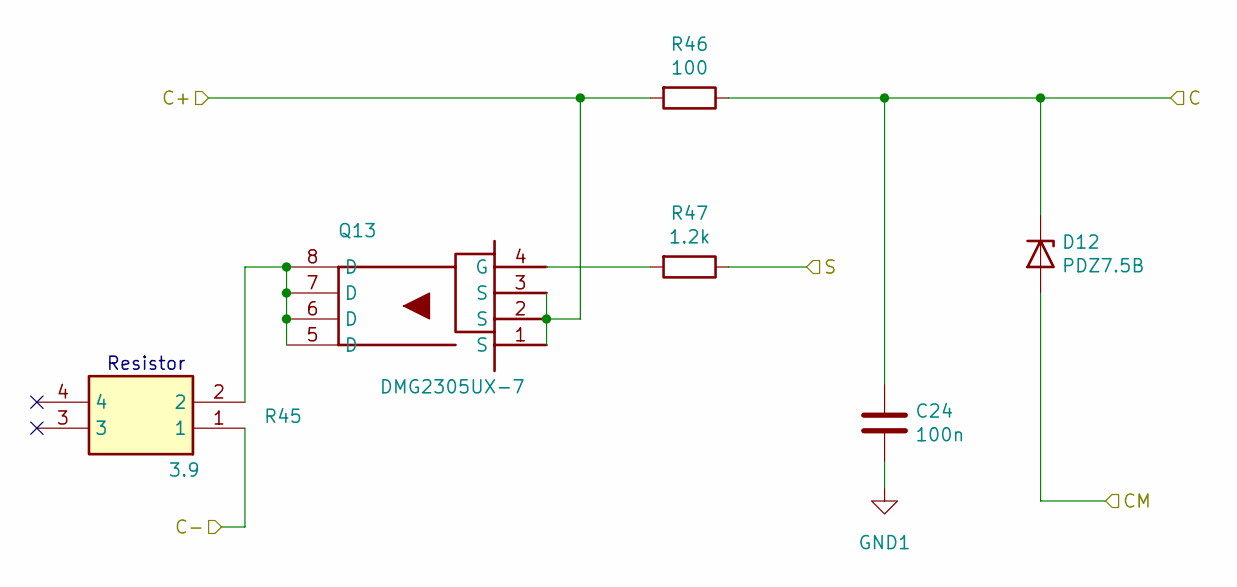
[picture p10: schematic cell.kicad_sch]

Parts:
C24: 100n; C_0603_1608Metric; MPN CC0603KRX7R0BB104
D12: PDZ7.5B; D_SOD-323; MPN PDZ7.5BZ
Q13: DMG2305UX-7; SOT-23; MPN DMG2305UX-7; Mouser Part Number 621-DMG2305UX-7-F
R45: 3.9; R_2512_6332Metric; MPN CRCW25123R90JNEA
R46: 100; R_0603_1608Metric; MPN RC0603FR-07100RL
R47: 1.2k; R_0603_1608Metric; MPN RC0603JR-073K3L

Connections:
C: C24.1, D12.1 (K), R46.1
C+: Q13.1 (S), Q13.2 (S), Q13.3 (S), R46.2
C-: R45.1
CM: D12.2 (A)
GND1: C24.2
unnamed: Q13.4 (G), R47.2
unnamed: Q13.5 (D), Q13.6 (D), Q13.7 (D), Q13.8 (D), R45.2
S: R47.1

Notes on the sheet:
Resistor
