Julius-eng/Vector-BMS/(commit log)

2026-03-11 Create Vector-BMS
    [MCU.kicad_sch, Vector_BMS.kicad_pcb, Vector_BMS.kicad_sch, cell.kicad_sch, cell2.kicad_sch]
2026-03-11 Replace broken 8-pin DMG2305UX symbol with correct 3-pin SamacSys version
    - Updated lib_symbols with official DMG2305UX-7 symbol (G/S/D pins 1/2/3)
    - Added SOT96P240X115-3N footprint file
    - Applied to both cell.kicad_sch and cell2.kicad_sch
    Note: Wire connections may need adjustment in KiCad GUI since pin geometry changed
    [cell.kicad_sch, cell2.kicad_sch]
2026-03-11 Adjust balancing resistor and balancing mosfet
    [Vector_BMS.kicad_sch, cell.kicad_sch, cell2.kicad_sch]
2026-03-11 Replace BUK98150-55A with IRFL4105PBF (Q18, Q19, Q20)
    BUK98150-55A has limited availability. IRFL4105PBF is a drop-in replacement:
    - Same package (SOT-223)
    - Same voltage (55V)
    - Lower Rds(on) (45mΩ vs 137mΩ)
    - 3.7A vs 5.5A current rating
    - In stock at DigiKey/Mouser
    [Vector_BMS.kicad_sch]
2026-03-11 Replace R92 shunt resistor with smaller WSLP5931L1000FEA
    CSM2F-8518-L100J01 (85×18mm) → WSLP5931L1000FEA (15×7.6mm)
    - Same resistance: 0.1mΩ
    - 15W rating (plenty for 120A @ 1.44W)
    - 5.6× smaller footprint
    - Better tolerance: ±1% vs ±5%
    - LCSC: $0.93
    [Vector_BMS.kicad_sch]
2026-03-11 Replace U7 ISL28022 (EOL) with INA226
    ISL28022FUZ-T7A → INA226AIDGSR
    - Pin-compatible drop-in replacement
    - Same VSSOP-10 footprint
    - Same I2C interface
    - ISL28022 was EOL'd Dec 2019
    - INA226 actively produced by TI
    [Vector_BMS.kicad_sch]
2026-03-11 Add comprehensive README
    - Hardware architecture overview
    - Component table with part numbers
    - Cell configuration and current sensing specs
    - VESC CAN integration details
    - MCU capabilities and firmware functions
    - Connector pinout reference
2026-03-12 Add firmware skeleton and installation instructions
    Firmware:
    - platformio.ini: PlatformIO build config for STM32L476
    - bms_config.h: Configurable parameters (thresholds, limits)
    - ltc6811.h: LTC6811 battery monitor driver header
    - ina226.h: INA226 current sensor driver header
    - main.c: Main application with BMS state machine
    README updates:
    - Fixed balance current: ~1A @ 4.2V (3.9Ω resistor), not 100mA
    - Added firmware directory structure
    - Added installation instructions (PlatformIO)
    - Added build/flash commands
    - Added configuration guide
    - Added balance resistor to component table
2026-03-12 Switch to VESC BMS firmware
    Removed custom firmware skeleton in favor of using VESC BMS firmware
    (https://github.com/vedderb/vesc_bms_fw) which provides:
    - Full VESC Tool integration
    - Proven cell balancing algorithms
    - CAN protocol already implemented
    - Distributed balancing support
    - Bootloader and OTA updates
    Added Vector BMS hardware configuration:
    - firmware/vesc_bms_hw/hw_vector_bms.h - Pin definitions
    - firmware/vesc_bms_hw/hw_vector_bms.c - Initialization, INA226 support
    Key hardware mappings:
    - SPI1: LTC6820 isoSPI (PA4-PA7)
    - I2C1: INA226 current sensor (PB6-PB7)
    - CAN1: VESC communication via ISO1050 (PB8-PB9)
    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
