Julius-eng/Vector-BMS/(notices)

Notices in the files:
firmware/vesc_bms_hw/hw_vector_bms.h:
The VESC BMS firmware is free software: you can redistribute it and/or modify
it under the terms of the GNU General Public License as published by
the Free Software Foundation, either version 3 of the License, or
(at your option) any later version.
